yggdrion/wooting-waveshare/stl/case_full.stl

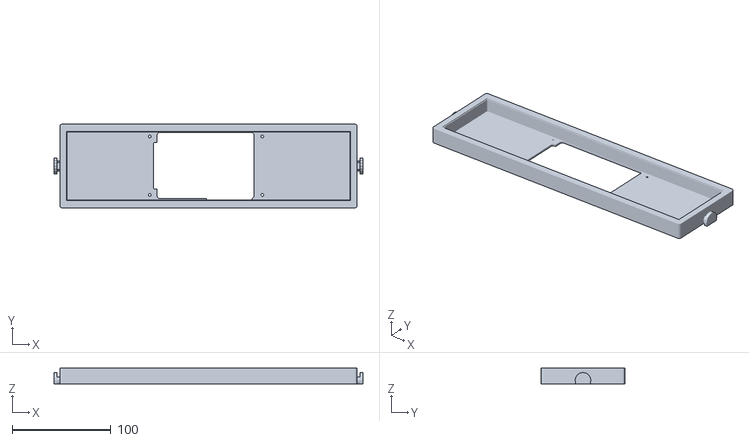
[picture p7: CAD file, 2026-10-22]
stl/case_full.stl
312.5 x 84.7 x 15.8
