yggdrion/wooting-waveshare/stl/case_end_left.stl

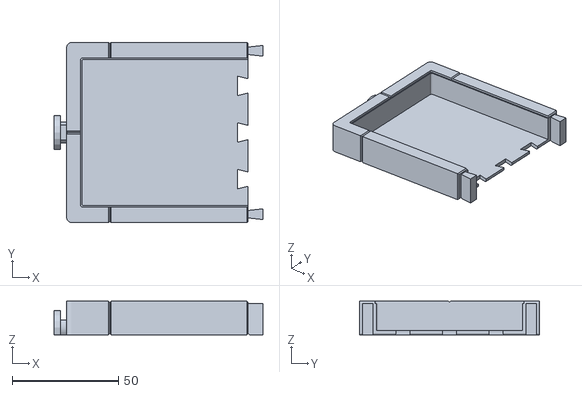
[picture p8: CAD file, 2026-10-22]
stl/case_end_left.stl
98.2 x 84.7 x 15.8
