yggdrion/wooting-waveshare/stl/case_mid.stl

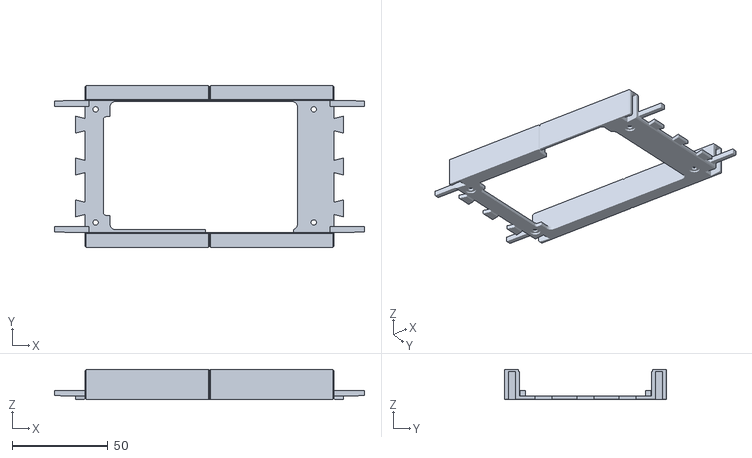
[picture p9: CAD file, 2026-10-22]
stl/case_mid.stl
162.0 x 84.7 x 15.8
