yggdrion/wooting-waveshare/stl/cover.stl

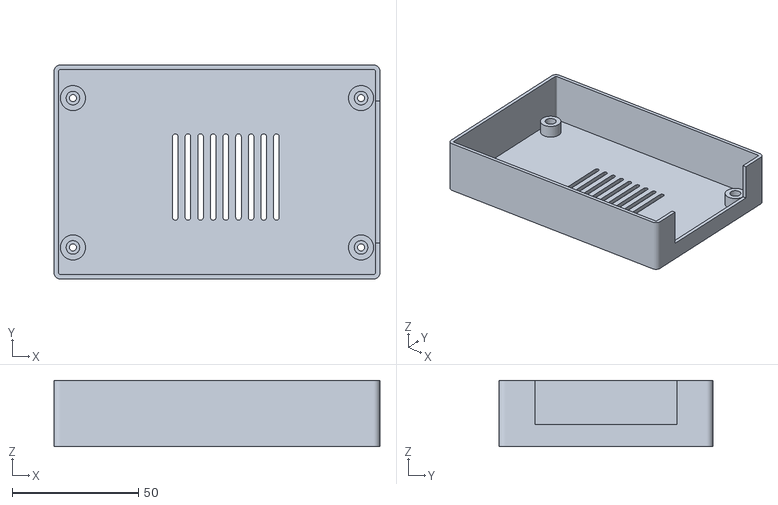
[picture p10: CAD file, 2026-10-22]
stl/cover.stl
129.0 x 84.7 x 26.2
