yggdrion/wooting-waveshare/stl/stand_right.stl

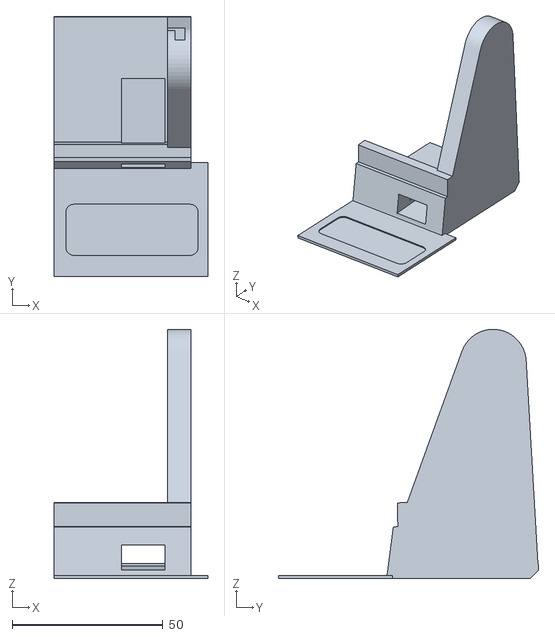
[picture p11: CAD file, 2026-10-22]
stl/stand_right.stl
51.0 x 86.3 x 82.8
