yggdrion/wooting-waveshare/stl/pad.stl

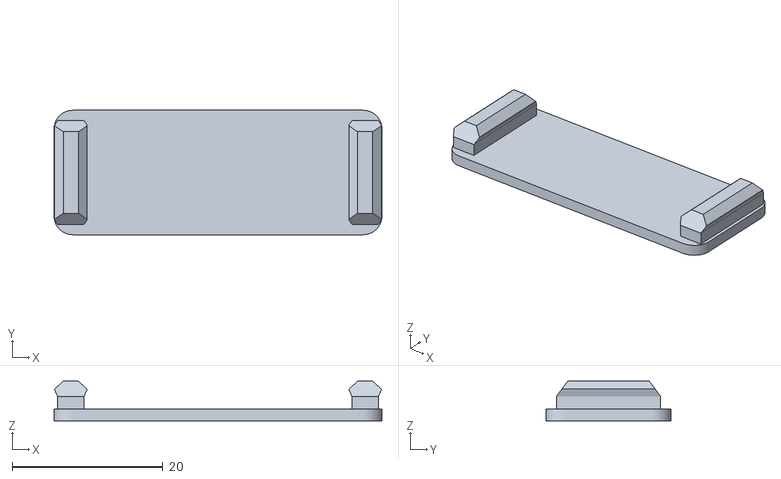
[picture p12: CAD file, 2026-10-22]
stl/pad.stl
43.5 x 16.5 x 5.25
