yggdrion/wooting-waveshare/kb_rear_profile.scad

// keyboard rear-edge fill profile [Y, Z] (keyboard underside - 0.3 mm), generated from the Wooting STEP
kb_rear_profile = [[66.0, -40.0], [66.0, -17.41], [66.25, -17.42], [66.5, -17.43], [66.75, -17.44], [67.0, -17.45], [67.25, -17.47], [67.5, -17.48], [67.75, -17.49], [68.0, -17.5], [68.25, -17.52], [68.5, -17.53], [68.75, -17.54], [69.0, -17.55], [69.25, -17.56], [69.5, -17.58], [69.75, -17.58], [70.0, -17.58], [70.25, -17.03], [70.5, -15.61], [70.75, -14.19], [71.0, -12.77], [71.25, -11.36], [71.5, -9.94], [71.75, -8.52], [72.0, -7.1], [72.25, -5.68], [72.5, -4.27], [72.75, -2.85], [73.0, -1.43], [73.25, -1.4], [73.5, -1.4], [73.75, -1.4], [74.0, -1.4], [74.25, -1.4], [74.5, -1.4], [74.75, 6.5], [75.0, 6.5], [75.25, 6.5], [75.5, 6.5], [75.75, 6.5], [76.0, 6.5], [76.25, 6.5], [76.5, 6.5], [76.75, 6.5], [77.0, 6.5], [77.25, 6.5], [77.5, 6.5], [77.75, 6.5], [78.0, 6.5], [78.25, 6.5], [78.5, 6.5], [78.75, 6.5], [79.0, 6.5], [79.0, -40.0]];
