yggdrion/wooting-waveshare/(list of files, cad)

Other CAD files:
stl/case_end_right.stl
stl/stand_left.stl
