yggdrion/wooting-waveshare/images/assembly_side.png

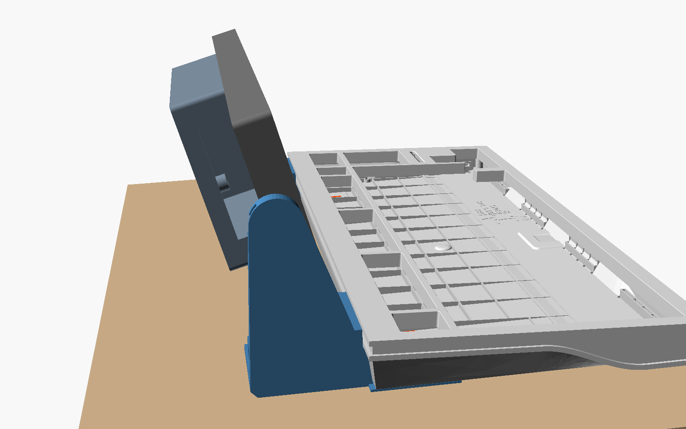
images/assembly_side.png
